TZlindra/ELEC291Project2/Report/main.tex

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

\title{ELEC 291 : Metal Detecting Robot}
\author{Team A9}
\date{April 12th, 2024}

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

\linespread{1.6}
\setlength{\parindent}{0pt} % Disable paragraph indentation

\lstset{style=mystyle}

\begin{document}

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

\newpage

\tableofcontents

\newpage
\section{Introduction}

\subsection{Objective}

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

\

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

\subsection{System Block Diagrams}

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

\section{Investigation}

Prior to settling on a final design, we individually and collaboratively scoped out the
constraints of our project components (listed in the project requirements in Table \ref{tab:project_requirements}).

\subsection{Idea Generation}

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

\subsection{Investigation Design}

To begin our design, we leveraged our knowledge of Labs 4-6 to understand how sub-circuitry and software modules should be implemented.
A few components required further research, such as the Colpitts Oscillator for the metal detector, and the JDY-40 radio module for data transmission. %ToDo : Add Bibliography
For our circuitry, we referred to datasheets to ensure our electrical components were powered in the appropriate voltage ranges.
We also determined capacitances which would enable a stable steady state for the Colpitts Oscillator and for us to meet expected inductance values.
We spent some time understanding the limitations of the JDY-40 and how to properly configure them for communication between the two microcontrollers.

\subsection{Data Collection}

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

\

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

\

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

\subsection{Data Synthesis}

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

\

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

\subsection{Analysis of Results}

From the graphs in \ref{fig:movement_controls_logs} and \ref{fig:movement_controls_logs}, we noted that the latency is displayed as a number of samples. This was due to the fact that we had
many samples per second and wanted to visualize the microcontroller responsiveness to new information. In Figure \ref{fig:movement_controls_logs}, we
see that the direction and speed was transmitted accurately from the STM32 to the EFM8. We modified both X and Y coordinates to test possible combinations and this was received in a reasonable number of samples.
In Figure \ref{fig:inductance_detection_logs}, we see that the inductance values exhibited similar transmission behavior upon change.

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

\section{Design}

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

\subsection{Use of Process}

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

\

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

\

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

\

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

\subsection{Need and Constraint Identification}.

During firmware development, we identified the following constraints from the
documents provided by Dr. Jesus Calvino-Fraga, as well as from our own comprehension : \\

\begin{table}[ht]
    \center
    \begin{tabular}{|l|p{0.6\linewidth}|}
        \hline
        \textbf{Requirements} \\ \hline
        The controller and robot must be driven by two microcontrollers from \\
        different families (e.g., ARM Cortex and 8051). \\ \hline
        The robot must be able to detect metal using an inductor built from \\
        magnet wire and a coil frame. \\ \hline
        The robot must be powered by AA batteries to drive wheels and 9V for \\
        the remaining functions. \\ \hline
        The speed and direction of the robot must be smoothly controlled with a joystick. \\ \hline
        The controller and the robot must wirelessly transmit data to one another. \\ \hline
        The metal detected by the robot should be indicated to \\
        the user via visual and auditory feedback. \\ \hline
        The transmission of data must be reliable and accurate. \\ \hline
    \end{tabular}
    \label{tab:project_requirements}
    \caption{List of Project Requirements}
\end{table}

\subsection{Problem Specification}

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

\

\textbf{JDY Communications}
A key module which required extensive development time was the JDY-40 communication between the STM32 and EFM8 microcontrollers.
The bugs caused by this were the main blocker in integrating our firmware, as the communication was not reliable and often failed to transmit
data between the two microcontrollers.

\

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

\

A major obstacle was finding that Git commits with a functional JDY-40 module would suddenly behave erratically
(i.e. transmission delays, inaccurate data to be received). We believe this was partially due to software bugs, but also due to the high number of \textit{JDY-40s}
in the lab environment during the latter part of the project.

\

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

\

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

\

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

\subsection{Solution Generation}

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

\

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

\

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

\

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

\subsection{Solution Evaluation}

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

\subsection{Safety/Professionalism}

To ensure our product was safe, we developed many safety algorithms in the program. Before the robot can be controlled, the user must enter a 4 digit passcode
to "unlock" the remote controller. This was paired with a lock feature which would disable the controller in the need of an emergency or other purpose. In tandem with this,
we had a power switch to both conserve battery life and to ensure that the robot could not be controlled in this state. In addition, we implemented a speed limiter and turn
limiter on the remote controller for the movement of the robot. If the user wishes to operate at a lower speed without the risk of too much speed, a simple click would enable this.

\

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

\subsection{Detailed Design}

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

As seen in Figure \ref{fig:stm32}, the relevant circuits
include the voltage dividers, joystick (ADC), JDY-40, and LCD. Conversely, in the Figure \ref{fig:efm8}, the important circuits
were the voltage dividers, JDY-40, metal detector and optocoupler/H-bridge circuits.

\

\textbf{Voltage Dividers} \\
We had a total of 4 step down voltage dividers for this project. Since the controller and the robot needed to be battery powered, we were required to use an LM7805 to drop the voltage of a standard 9V alkaline battery to 5V to power circuits such as the EFM8, LCD, speakers and the metal detector circuit. For stabilizing capacitors we used 0.22uF and 0.1uF capacitors as shown in the LM7805 datasheet. Subsequently, this 5V voltage was also dropped down to a voltage of 3v3 to power the ADC, JDY-40s and the STM32. We used 2 1uF capacitors to stabilize the signal.

\

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

\

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

\

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

\

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

\subsubsection{Firmware Design}
This project required a strong firmware foundation to ensure the robot behaved as intended. This entailed developing $C$ programs in close coordination for the STM32 and EFM8 systems.
The fundamental modules include the joystick input standardization, movement logic/PWM control, JDY-40 communications, speakers, and period calculations (metal detector).

\

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

This was paired with some more logic to convert this number into a percentage from 1-100\% for the x and y directions. As shown in Figure \ref{lst:movementstandardized2}, the value was divided by the total in the direction it was pointed to get a percent. This was paired with a minimum
 active threshold of 5\%, due to the joystick value fluctuating slightly when it was not in motion.
\begin{lstlisting} [language=C, caption={PWM Percentage Conversion}, label={lst:movementstandardized2}, basicstyle=\ttfamily\tiny]
if (y_value > MINIMUM_PERCENT_ACTIVE * (4095 - Y_MIDPOINT) || y_value < - MINIMUM_PERCENT_ACTIVE * Y_MIDPOINT) {
    if (y_value >= 0) standardized = (int)(100 * y_value / (4095 - Y_MIDPOINT));
    else if (y_value < 0) standardized = (int)(100 * y_value / (Y_MIDPOINT));
}
\end{lstlisting}

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

\

\textbf{JDY-40 Communications} \\

In order to share data between microcontrollers, we had to ensure our firmware operated deterministically and reliably.
This required ensuring that the data received by each microcontroller was accurate to the transmitted data. It also required ensuring
that this did not slow down the remaining functionality of the system, especially for the robot EFM8 microcontroller.

\

As seen in Figure \ref{fig:firmware_block_diagram}, we decided to periodically transmit data to the JDY-40 radio. This was done
asynchronously via ISRs. Receiving and parsing the data was done in the main function however,
as the subsequent instructions depended on a newly received value. This appeared as a function call to the following function on the STM32.
Note that this only updates the global variable \texttt{RX\_BUFF} when 2 bytes are received.

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

We prioritized frequent data transmission of movement controls from the joystick and implemented an STM32 ISR with a software counter
to transmit this every $250 ms$ via UART communication. This ensured we can smoothly control the speed and
direction of the PWM for the robot Optocoupler and H-Bridge circuitry.

\begin{lstlisting} [language=C, caption={EFM8 : Timer 21 ISR}, label={lst:timer21isr}, basicstyle=\ttfamily\tiny]
void TIM21_Handler(void) {
	TIM21->SR &= ~BIT0; // Clear Update Interrupt Flag
	TX21Count++;

	if (TX21Count > 250) {
		TX21Count = 0;
		TX_XY();
	}
}
\end{lstlisting}

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

\

Data parsing and validation was an additional layer of complicated for the EFM8 system, as we needed to accurately process the X, Y, and Z values from
the STM32 transmission. This involved checking the length to ensure it was within the expected range of 12-14 characters. Note that we had to transmit a fixed length from the
STM32 to account for this. Following this initial validation, we implemented a custom function to trim the non-numeric characters from the string, and assign the relevant data
to the respect variables. This is shown in the Appendix (\ref{lst:efm8_jdy40rx}).

\

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

\

\textbf{Period Measurement and Inductance Calculation}

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

    ... // Wait for the signal to go low

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

    return (overflow_count*65536+TH0*256+TL0);
}
\end{lstlisting}

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

    return (int)(MILLI_MULTIPLIER * MILLI_MULTIPLIER * I_kH);
}
\end{lstlisting}

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

\

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

\

\textbf{Speaker} \\
We implemented the speaker on the controller using Timer 2 of the STM32. We used a base frequency of 7040Hz, as this allowed us to output an clear and observable
"A" note (sample chart shown here: \ref{fig:music_frequencies}), whereas other frequencies have decimal points (dividing the frequency by $2^n$).
In the code shown in \ref{lst:Speaker}, the \texttt{new\_ratio} value served as a counter in the Timer 2 ISR to control the PWM speed for the speaker.
The change in frequency was tied to the inductance value measured by the EFM8.

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

    new_freq = TICK_FREQ_TIM2 / new_ratio;

    return new_ratio;
}
\end{lstlisting}

\noindent

\subsection{Solution Assessment}

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

\

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

    ... # Parse and Process Data

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

    if log_df.empty:
        log_df = new_df
    else:
        log_df = pd.concat([log_df, new_df], ignore_index=True)

    s += 1

log_df.to_csv('Coordinate_Logs.csv', index=False)
\end{lstlisting}

This generated the $csv$ file with the following data in Table \ref{table:coordinates_log_table}.

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

We performed a similar test for inductance logs in Table \ref{table:inductance_log_table}.

\section{Life Long Learning}

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

\

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

\

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

\section{Conclusion}

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

\renewcommand{\refname}{}

\newpage

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

    \bibitem{SlidesPDF} Calvino-Fraga, Jesus, \textit{ELEC291\_Project\_2\_Met}. University of British Columbia, 2024.

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

\end{thebibliography}

\section{Bibliography}
\begin{itemize}
    \item ChatGPT, chat.openai.com, 2022.
    \item EFM8 Laser Bee Family EFM8LB1 Data Sheet - Silicon Labs, www.silabs.com/documents/public/data-sheets/efm8lb1-datasheet.pdf, 2024.
    \item EFM8 Laser Bee Family EFM8LB1 Reference Manual, www.silabs.com/documents/public/reference-manuals/efm8lb1-rm.pdf, 2019.
    \item JDY-40 Wireless Serial Port Module, w.electrodragon.com/w/images/0/05/EY-40\_English\_manual.pdf.
    \item Merlo, Maria Grazia. “The 4 Principles of an Effective Work Breakdown Structure.” A Journey into Software Best Practices with Maria Grazia Merlo, mariagraziamerlo.com/2015/12/27/the-4-core-principles-of-an-effective-work-breakdown-structure/, 2015.
    \item Microchip, ww1.microchip.com/downloads/aemDocuments/documents/APID/ProductDocuments/DataSheets/MCP1700-Data-Sheet-20001826F.pdf, 2022.
    \item Mouser, www.mouser.com/datasheet/2/239/LTV-8X7\_series\_201610\_-1544776.pdf.
    \item STM32, Datasheet - Stm32l051x6 Stm32l051x8 - Access Line, www.st.com/resource/en/datasheet/stm32l051c6.pdf, 2019.
    \item STM32, RM0377 Reference Manual - -Based 32-Bit Mcus, www.st.com/resource/en/reference\_manual/rm0377-ultralowpower-stm32l0x1-advanced-armbased-32bit-mcus-stmicroelectronics.pdf, 2022.
    \item Storr, Wayne. “Colpitts Oscillator Tutorial and Colpitts Oscillator Design.” Basic Electronics Tutorials, www.electronics-tutorials.ws/oscillator/colpitts.html, 2022.
\end{itemize}

\clearpage
\section{Appendix}

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

\begin{figure}[htbp]
    \centering
    
    \caption{Example JDY-40 connections with a Microcontroller}
    \label{fig:JDY-40}
\end{figure}

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

    count++;

\end{lstlisting}

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

        SFRPAGE=0x10;
        TF4H = 0; // Clear Timer4 interrupt flag
        TXcount++;

        if(TXcount >= 250){
            TXcount=0;
            flag == 0;
        }

        if (current_TR0 == 1) TR0 = 1;
        if (current_TR5 == 1) TR5 = 1;
    }
\end{lstlisting}

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

    //printf("%p \n", y);
    //printf("%p \n", x);

    *xin = stringToInt(x);
    *yin = stringToInt(y);
    *zyn = stringToInt(z);

    free(x);
    free(y);
    free(z);
}
\end{lstlisting}

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

    // printf("Frequency: %ld Hz\n", frequency);

    if (count>0) return frequency;
    else return 0;
}
\end{lstlisting}

\end{document}
