TZlindra/ELEC291Project2/(list of files, cad)

Other CAD files:
EFM8/Examples/LCD/main.obj
EFM8/Robot/Source_Code/main.obj
EFM8/Examples/ADC/ADC.obj
EFM8/Examples/All_timers/All_timers.obj
EFM8/Examples/Blinky/Blinky.obj
EFM8/Examples/BlinkyISR/BlinkyISR.obj
EFM8/Examples/HelloWorld/HelloWorld.obj
EFM8/Examples/JDY40/EFM8_JDY40_test.obj
EFM8/Examples/LCD/lcd.obj
EFM8/Examples/Period/PeriodEFM8.obj
EFM8/Examples/Professor_JDY/EFM8_JDY40_test.obj
EFM8/Examples/Robot_Base/Robot_Base.obj
EFM8/Examples/Uart1/EFM8_uart1_test.obj
EFM8/Robot/EFM8_Prog/EFM8_prog.obj
EFM8/Robot/Source_Code/movement.obj
STM32/Examples/stm32flash/BO230/BO230.obj
STM32/Examples/WAV_Sound/computer_sender.obj
STM32/stm32flash/BO230/BO230.obj
EFM8/Examples/LCD/startup.obj
EFM8/Robot/Source_Code/JDY40.obj
EFM8/Robot/Source_Code/movement_integration.obj
EFM8/Robot/Source_Code/global.obj
EFM8/Robot/Source_Code/speaker.obj
EFM8/Robot/Source_Code/inductance.obj
