TZlindra/ELEC291Project2/Regression_Tests/Inductance/Inductance_Logs.csv

Datetime | Robot Inductance | Controller Inductance
2024-04-11 13:44:07.003536 | 492.0
2024-04-11 13:44:07.058682 | 490.0 | 490.0
2024-04-11 13:44:07.346862 | 490.0 | 490.0
2024-04-11 13:44:07.627616 | 490.0 | 490.0
2024-04-11 13:44:07.934766 | 492.0 | 490.0
2024-04-11 13:44:08.224805 | 492.0 | 490.0
2024-04-11 13:44:08.516710 | 490.0 | 490.0
2024-04-11 13:44:08.801755 | 490.0 | 490.0
2024-04-11 13:44:09.091120 | 490.0 | 490.0
2024-04-11 13:44:09.396327 | 490.0 | 487.0
2024-04-11 13:44:09.677981 | 492.0 | 490.0
2024-04-11 13:44:09.966508 | 490.0 | 490.0
2024-04-11 13:44:10.253418 | 492.0 | 490.0
2024-04-11 13:44:10.564472 | 490.0 | 487.0
2024-04-11 13:44:10.849895 | 490.0 | 487.0
2024-04-11 13:44:11.139413 | 490.0 | 490.0
2024-04-11 13:44:11.421172 | 490.0 | 490.0
2024-04-11 13:44:11.733601 | 490.0 | 490.0
2024-04-11 13:44:12.010898 | 490.0 | 490.0
2024-04-11 13:44:12.309989 | 492.0 | 490.0
2024-04-11 13:44:12.595442 | 492.0 | 490.0
2024-04-11 13:44:12.902049 | 490.0 | 490.0
2024-04-11 13:44:13.186210 | 490.0 | 490.0
2024-04-11 13:44:13.475678 | 487.0 | 490.0
2024-04-11 13:44:13.763262 | 480.0 | 490.0
2024-04-11 13:44:14.068412 | 480.0 | 487.0
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
