TZlindra/ELEC291Project2/Regression_Tests/Coordinates/Coordinate_Logs.csv

Datetime | Robot X | Robot Y | Robot Z | Controller X | Controller Y | Controller Z
2024-04-09 15:34:41.234182 |  |  |  | 0.0 | 0.0 | 0.0
2024-04-09 15:34:41.336645 |  |  |  | 0.0 | 0.0 | 0.0
2024-04-09 15:34:41.624354 | 0.0 | 0.0 | 0.0 | 0.0 | 0.0 | 0.0
2024-04-09 15:34:41.912171 | 0.0 | 0.0 | 0.0 | 0.0 | 99.0 | 0.0
2024-04-09 15:34:42.202581 | 0.0 | 0.0 | 0.0 | 0.0 | 99.0 | 0.0
2024-04-09 15:34:42.493474 | 0.0 | 99.0 | 0.0 | 0.0 | 99.0 | 0.0
2024-04-09 15:34:42.797305 | 0.0 | 99.0 | 0.0 | 0.0 | 99.0 | 0.0
2024-04-09 15:34:43.082199 | 0.0 | 99.0 | 0.0 | 0.0 | 99.0 | 0.0
2024-04-09 15:34:43.372573 | 0.0 | 99.0 | 0.0 | 0.0 | 99.0 | 0.0
2024-04-09 15:34:43.656584 | 0.0 | 99.0 | 0.0 | 0.0 | 99.0 | 0.0
2024-04-09 15:34:43.948304 | 0.0 | 99.0 | 0.0 | 0.0 | 99.0 | 0.0
2024-04-09 15:34:44.247106 | 0.0 | 99.0 | 0.0 | 0.0 | 99.0 | 0.0
2024-04-09 15:34:44.542237 | 0.0 | 99.0 | 0.0 | 0.0 | 99.0 | 0.0
2024-04-09 15:34:44.832331 | 0.0 | 99.0 | 0.0 | 0.0 | 99.0 | 0.0
2024-04-09 15:34:45.117004 | 0.0 | 99.0 | 0.0 | 0.0 | 99.0 | 0.0
2024-04-09 15:34:45.408791 | 0.0 | 99.0 | 0.0 | 99.0 | 99.0 | 0.0
2024-04-09 15:34:45.710676 | 0.0 | 99.0 | 0.0 | 99.0 | 99.0 | 0.0
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
