TZlindra/ELEC291Project2/STM32/Controller/main.c

// LQFP32 pinout
//                    ----------
//              VDD -|1      32|- VSS
//             PC14 -|2      31|- BOOT0
//             PC15 -|3      30|- PB7 (Button D)
//             NRST -|4      29|- PB6 (Button C)
//             VDDA -|5      28|- PB5 (Button B)
// LCD_RS      PA0 -|6       27|- PB4
// LCD_E       PA1 -|7       26|- PB3 (Button A)
// LCD_D4      PA2 -|8       25|- PA15 (USART2 RX)
// LCD_D5      PA3 -|9       24|- PA14 (USART2 TX)
// LCD_D6      PA4 -|10      23|- PA13
// LCD_D7      PA5 -|11      22|- PA12 (Button)
//             PA6 -|12      21|- PA11
//             PA7 -|13      20|- PA10 (Reserved for RXD)
// (ADC_IN8)   PB0 -|14      19|- PA9  (Reserved for TXD)
// (ADC_IN9)   PB1 -|15      18|- PA8  (Speaker)
//             VSS -|16      17|- VDD
//                    ----------

#include "global.h"
#include "lcd.h"
#include "speaker.h"
#include "adc.h"
#include "UART2.h"
#include "JDY40.h"
#include "movement.h"
#include "frequency_calc.h"
#include "passcode.h"

char LCD_BUFF[CHARS_PER_LINE]; // Buffer for LCD Display

volatile int Timer2Count = 0;
volatile int TX21Count = 0;
volatile float SpeakerRatio = 1;
volatile int SpeakerEnabled = 0;
int ForceSpeakerOff = 0;

volatile float inductance_microH = 0;

float x = 0, y = 0, z = 0;
int standardized_x = 0, standardized_y = 0;
int sensitivity_x = 0, sensitivity_y = 0;

void ConfigPinsLCD(void);
void ConfigPinButtonZ(void);
void ConfigPinADC(void);
void ConfigPinsUART2(void);
void ConfigPinSpeaker(void);
void ConfigPasscodeButtonPins(void);

void display_x_y(int x, int y);
void display_adc(float x, int standardized_x, float y, int standardized_y);
void display_inductance_mH(float inductance_mH);

// Interrupt service routines are the same as normal
// subroutines (or C funtions) in Cortex-M microcontrollers.
// The following should happen at a rate of 1kHz.
// The following function is associated with the TIM2 interrupt
// via the interrupt vector table defined in startup.c
void TIM2_Handler(void) {
	TIM2->SR &= ~BIT0; // Clear Update Interrupt Flag
	Timer2Count++;
	if ((Timer2Count >= SpeakerRatio) && (SpeakerEnabled == 1) && (ForceSpeakerOff == 0)) {
		TIM2->CCR1 = (TIM2->CCR1+16)&0xFF;
		Timer2Count = 0;
		ToggleSpeaker(); // Toggle Speaker
	}
}

void TIM21_Handler(void) {
	TIM21->SR &= ~BIT0; // Clear Update Interrupt Flag
	TX21Count++;

	if (TX21Count > 250) {
		TX21Count = 0;
		TX_XY();
	}
}

void ConfigPinsLCD(void) {
	RCC->IOPENR |= BIT0; // peripheral clock enable for port A

	// Make pins PA0 to PA5 outputs (page 200 of RM0451, two bits used to configure: bit0=1, bit1=0)
    GPIOA->MODER = (GPIOA->MODER & ~(BIT0|BIT1)) | BIT0; // PA0
	GPIOA->OTYPER &= ~BIT0; // Push-pull

    GPIOA->MODER = (GPIOA->MODER & ~(BIT2|BIT3)) | BIT2; // PA1
	GPIOA->OTYPER &= ~BIT1; // Push-pull

    GPIOA->MODER = (GPIOA->MODER & ~(BIT4|BIT5)) | BIT4; // PA2
	GPIOA->OTYPER &= ~BIT2; // Push-pull

    GPIOA->MODER = (GPIOA->MODER & ~(BIT6|BIT7)) | BIT6; // PA3
	GPIOA->OTYPER &= ~BIT3; // Push-pull

    GPIOA->MODER = (GPIOA->MODER & ~(BIT8|BIT9)) | BIT8; // PA4
	GPIOA->OTYPER &= ~BIT4; // Push-pull

    GPIOA->MODER = (GPIOA->MODER & ~(BIT10|BIT11)) | BIT10; // PA5
	GPIOA->OTYPER &= ~BIT5; // Push-pull
}

void ConfigPinButtonZ() {
	RCC->IOPENR |= RCC_IOPENR_GPIOAEN; // Peripheral Clock Enable for Port A
	GPIOA->MODER &= ~(BIT24 | BIT25); // Make Pin PA12 Input

	// Activate Pull-Up Resistor for Pin PA12
	GPIOA->PUPDR |= BIT24;
	GPIOA->PUPDR &= ~(BIT25);
}

void ConfigPinADC(void) {
	// Configure the pin used for analog input: PB0 (pin 14)
	RCC->IOPENR |= RCC_IOPENR_GPIOBEN; // Peripheral Clock Enable for Port B
	GPIOB->MODER |= (BIT0|BIT1);  // Select analog mode for PB0 (pin 14 of LQFP32 package)

	// Configure the pin used for analog input: PB1 (pin 15)
	RCC->IOPENR  |= BIT1;         // peripheral clock enable for port B
	GPIOB->MODER |= (BIT2|BIT3);  // Select analog mode for PB1 (pin 15 of LQFP32 package)
}

void ConfigPinsUART2(void) {
	GPIOA->OSPEEDR = 0xFFFFFFFF; // All pins of port A configured for very high speed! Page 201 of RM0451

	RCC->IOPENR |= RCC_IOPENR_GPIOAEN; // Enable clock for GPIO Port A

    GPIOA->MODER = (GPIOA->MODER & ~(BIT27|BIT26)) | BIT26; // Make pin PA13 output (page 200 of RM0451, two bits used to configure: bit0=1, bit1=0))
	GPIOA->ODR |= BIT13; // 'set' pin to 1 is normal operation mode.

	GPIOA->MODER &= ~(BIT22 | BIT23); // Make PA11 Input

	// Activate Pull-Up Resistor for Pin PA11
	GPIOA->PUPDR |= BIT22;
	GPIOA->PUPDR &= ~(BIT23);
}

void ConfigPinSpeaker(void) {
	RCC->IOPENR |= RCC_IOPENR_GPIOAEN; // Enable clock for GPIO Port A
    GPIOA->MODER = (GPIOA->MODER & ~(BIT17|BIT16)) | BIT16; // PA8
}

void ConfigLEDPins(void) {
    GPIOA->MODER = (GPIOA->MODER & ~(BIT12|BIT13)) | BIT12; // PA6
	GPIOA->OTYPER &= ~BIT6; // Push-pull

    GPIOA->MODER = (GPIOA->MODER & ~(BIT14|BIT15)) | BIT14; // PA7
	GPIOA->OTYPER &= ~BIT7; // Push-pull

}

void ConfigPasscodeButtonPins(void) {
    RCC->IOPENR |= RCC_IOPENR_GPIOBEN; // Peripheral Clock Enable for Port B
    GPIOB->MODER &= ~(BIT14 | BIT15); // Make Pin PB7 Input
	GPIOB->PUPDR |= BIT14;
	GPIOB->PUPDR &= ~(BIT15);

    GPIOB->MODER &= ~(BIT12 | BIT13); // Make Pin PB6 Input
	GPIOB->PUPDR |= BIT12;
	GPIOB->PUPDR &= ~(BIT13);

    GPIOB->MODER &= ~(BIT10 | BIT11); // Make Pin PB5 Input
	GPIOB->PUPDR |= BIT10;
	GPIOB->PUPDR &= ~(BIT11);

    GPIOB->MODER &= ~(BIT6 | BIT7); // Make Pin PB3 Input
	GPIOB->PUPDR |= BIT6;
	GPIOB->PUPDR &= ~(BIT7);
}

int isButtonPressedGPIOA(int ButtonPin) {
	return !(GPIOA->IDR & ButtonPin);
}

int isButtonPressedGPIOB(int ButtonPin) {
	return !(GPIOB->IDR & ButtonPin);
}

void display_x_y(int x, int y) {
	sprintf(LCD_BUFF, "MOV(%d, %d)", x, y);
	LCDprint(LCD_BUFF, 2, 1);
}

void display_adc(float x, int standardized_x, float y, int standardized_y) {
	sprintf(LCD_BUFF, "X:%.1f = %d", x, standardized_x);
	printf("%s\r\n", LCD_BUFF);
	LCDprint(LCD_BUFF, 1, 1);

	sprintf(LCD_BUFF, "Y:%.1f = %d", y, standardized_y);
	printf("%s\r\n", LCD_BUFF);
	LCDprint(LCD_BUFF, 2, 1);
}

void display_inductance_mH(float inductance_mH) {
	sprintf(LCD_BUFF, "I: %.3f mH", inductance_mH / MILLI_MULTIPLIER);
	LCDprint(LCD_BUFF, 1, 1);
}

void update_sensitivity_x(void) {
	int sensitivity_count = 0;

	if (isButtonPressedGPIOB(BUTTON_S0)) {
		waitms(DEBOUNCE);
		if (isButtonPressedGPIOB(BUTTON_S0)) {
			// printf("Sensitivity X: %d\r\n", sensitivity_x);
			sensitivity_x++;
			if (sensitivity_x == 3) sensitivity_x = 0;

			while(isButtonPressedGPIOB(BUTTON_S0) && sensitivity_count < 500) sensitivity_count++;
		}
	}
}

void update_sensitivity_y(void) {
	int sensitivity_count = 0;

	if (isButtonPressedGPIOB(BUTTON_S1)) {
		waitms(DEBOUNCE);
		if (isButtonPressedGPIOB(BUTTON_S1)) {
			// printf("Sensitivity Y: %d\r\n", sensitivity_x);
			sensitivity_y++;
			if (sensitivity_y == 3) sensitivity_y = 0;

			sensitivity_count = 0;
			while(isButtonPressedGPIOB(BUTTON_S1) && sensitivity_count < 500) sensitivity_count++;
		}
	}
}

void CheckForceSpeakerOff(void) {
	if (isButtonPressedGPIOB(BUTTON_S2)) {
		waitms(DEBOUNCE);
		if (isButtonPressedGPIOB(BUTTON_S2)) {
			ForceSpeakerOff = !ForceSpeakerOff;
		}
	}
}

void checkLock(void) {
	if (isButtonPressedGPIOB(BUTTON_S3)) {
		waitms(DEBOUNCE);
		if (isButtonPressedGPIOB(BUTTON_S3) && isButtonPressedGPIOB(BUTTON_S0)) {
			SpeakerEnabled = 0;
    		printf("LOCKED!\r\n");
    		LCDprint("LOCKED!", 1, 1);
    		LCDprint("", 2, 1);
    		waitms(1000); // Wait 1s
    		getPasscode();
		}
	}
}

void main(void) {
	int success_count = 0; // Used to Filter Inductance RX Noise
	int z_count = 0; // Used to Filter Button Z Noise

	ConfigPinsUART2();
	InitUART2(9600);
	ConfigJDY40();

	ConfigPinsLCD();
	LCD_4BIT();
	ConfigPinButtonZ();
	ConfigPinADC();
	ConfigPinSpeaker();
	ConfigPasscodeButtonPins();
	ConfigLEDPins();

	InitTimer2();
	InitTimer21();

	initADC();

	waitms(500); // Wait for putty to start.
	printf("\x1b[2J\x1b[1;1H"); // Clear screen using ANSI escape sequence.

    getPasscode();

	while (1) {
		checkLock();

		x = -1*(readADC(ADC_CHSELR_CHSEL8)-X_MIDPOINT);
		y = -1*(readADC(ADC_CHSELR_CHSEL9)-Y_MIDPOINT);

		z = 0;
		if (isButtonPressedGPIOA(BUTTON_Z)) {
			waitms(DEBOUNCE);
			if (isButtonPressedGPIOA(BUTTON_Z)) z = 1;

			z_count = 0;
			while(isButtonPressedGPIOA(BUTTON_Z) && z_count < 500) z_count++;
		}

		update_sensitivity_x();
		update_sensitivity_y();

		standardized_x = standardize_x(x, sensitivity_x);
		standardized_y = standardize_y(y, sensitivity_y);

		// printf("X:%d, Y:%d, Z:%d\r\n", standardized_x, standardized_y, z);

		Update_XYZ(standardized_x, standardized_y, z);
		RX_I(); // Receive Inductance Value

		// display_buffs();
		// inductance_microH = 850.0;
		inductance_microH = Update_I(inductance_microH);
		printf("%0f\r\n", inductance_microH);

		// if (isButtonPressedGPIOB(BUTTON_S2)) SpeakerRatio = SetSpeakerFreq(inductance_microH, SpeakerRatio);

		if ((inductance_microH < 473.0) && (inductance_microH >= 400.0)) {
			if (success_count++ >= 0) {
				SpeakerEnabled = 1;
				SpeakerRatio = SetSpeakerFreq(inductance_microH, SpeakerRatio);
			}
		} else {
			success_count = 0;
			SpeakerEnabled = 0;
		}

		CheckForceSpeakerOff();

		// Display the ADC values on the LCD

		display_inductance_mH(inductance_microH);
		display_x_y(standardized_x, standardized_y);

		fflush(stdout); // GCC printf wants a \n in order to send something.  If \n is not present, we fflush(stdout)
		waitms(200);
	}
}
