TZlindra/ELEC291Project2/EFM8/Robot/Source_Code/movement.c

#include "movement.h"

#define LEFT_MOTOR_LHS  P2_4    //brown
#define LEFT_MOTOR_RHS  P2_3    //black
#define RIGHT_MOTOR_LHS P2_2    //grey/brown
#define RIGHT_MOTOR_RHS P2_1    //red

volatile int count = 0;
volatile long int timer = 0;

int PWM_percent_y = 0;
int PWM_percent_x = 0;
float left_wheel = 0;
float right_wheel = 0;
float new_right_wheel;
int prev_PWM_percent_x = 0;
int prev_PWM_percent_y = 0;
int state = 0;

void TIMER5Init(void) {
    // Initialize timer 5 for periodic interrupts
	SFRPAGE=0x10;
	TMR5CN0=0x00;   // Stop Timer5; Clear TF5; WARNING: lives in SFR page 0x10
	CKCON1|=0b_0000_0100; // Timer 5 uses the system clock
	TMR5RL=(0x10000L-(SYSCLK/(2*TIMER_5_FREQ))); // Initialize reload value
	TMR5=0xffff;   // Set to reload immediately
	EIE2|=0b_0000_1000; // Enable Timer5 interrupts
	TR5=1;         // Start Timer5 (TMR5CN0 is bit addressable)
}

void Timer5_ISR (void) interrupt INTERRUPT_TIMER5 {
    int current_TR0 = TR0, current_TR5 = TR5;
	TR0 = 0, TR5 = 0;

	SFRPAGE=0x10;
	TF5H = 0; // Clear Timer5 interrupt flag

    // P1_2 = !P1_2;
    //P1_3 = !P1_3;
    //P2_1 = !P2_1;

    if (state)
    {
        if (timer > 50000)
        {
            timer = 0;
            state = 0;
            PWM_percent_y = 0;
            left_wheel = 0;
            new_right_wheel = 0;
        }
        else if (timer > 20000)
        {
            PWM_percent_y = 100;
            left_wheel = 75;
            new_right_wheel = 75;
        }
        else
        {
            PWM_percent_y = 100;
            left_wheel = 75;
            new_right_wheel = 0;
        }
        timer++;
    }

    if (count > 100)
    {
        count = 0;
    }
    if (PWM_percent_y >= 0)
    {
        LEFT_MOTOR_LHS = (count > left_wheel ) ? 0:1;
        RIGHT_MOTOR_LHS = (count > new_right_wheel) ? 0:1;
    }
    else
    {
        LEFT_MOTOR_LHS = (count > left_wheel) ? 1:0;
        RIGHT_MOTOR_LHS = (count > new_right_wheel) ? 1:0;
    }

    count++;

    if (current_TR0 == 1) TR0 = 1;
    if (current_TR5 == 1) TR5 = 1;
}

void idle(void) {
    LEFT_MOTOR_LHS = 0;
    RIGHT_MOTOR_LHS = 0;
    LEFT_MOTOR_RHS = 0;
    RIGHT_MOTOR_RHS = 0;
}

void straight(void) {
    LEFT_MOTOR_RHS = 0;
    RIGHT_MOTOR_RHS = 0;
}

void backward(void) {
    LEFT_MOTOR_RHS = 1;
    RIGHT_MOTOR_RHS = 1;
}

void PWM_manager(float x_value, float y_value) {
    if (x_value >= 0) // RIGHT TURN
    {
        left_wheel = abs(y_value);
        right_wheel = (100 - abs(x_value)) * abs(y_value) / 100;
    }
    else if (x_value < 0) // LEFT TURN
    {
        left_wheel = (100 - abs(x_value)) * abs(y_value) / 100;
        right_wheel = abs(y_value);
    }

    // to account for the RIGHT wheel being stronger than the LEFT wheel
    if (abs(y_value) <= 25) new_right_wheel = 0.9*right_wheel;
    else if (abs(y_value) <= 50) new_right_wheel = 0.95*right_wheel;
    else if (abs(y_value) <= 75) new_right_wheel = 0.95*right_wheel;
    else if (abs(y_value) <= 100) new_right_wheel = 0.95*right_wheel;
    else new_right_wheel = 0.95*right_wheel;
}

void movement_manager(float PWM_percent_y, float prev_PWM_percent_y) {
    if (prev_PWM_percent_y != PWM_percent_y)
    {
        if (PWM_percent_y >= 0)
        {
            straight();
        }
        else
        {
            backward();
        }
    }

}

void movement_init(void) {
    idle();
}

void movement_loop(float x, float y) {
        // printf("JDY x: %f, JDY y: %f\r\n", x, y);
        PWM_percent_x = x;
        PWM_percent_y = y;
        // printf("PWM_percent x: %f, PWM_percent y: %f\r\n", x, y);

        movement_manager(PWM_percent_y, prev_PWM_percent_y);
		PWM_manager(PWM_percent_x, PWM_percent_y);
        prev_PWM_percent_x = PWM_percent_x;
        prev_PWM_percent_y = PWM_percent_y;
}

void parking(void) {
    state = 1;
}
