TZlindra/ELEC291Project2/STM32/Controller/adc.c

#include  "../Common/Include/stm32l051xx.h"
#include "adc.h"

// All of this code is mostly copy/paste from the STM32L05X reference manual RM0451.

void initADC(void) {
	RCC->APB2ENR |= BIT9; // peripheral clock enable for ADC (page 175 or RM0451)

	// ADC clock selection procedure (page 746 of RM0451)
	/* (1) Select PCLK by writing 11 in CKMODE */
	ADC1->CFGR2 |= ADC_CFGR2_CKMODE; /* (1) */

	// ADC enable sequence procedure (page 745 of RM0451)
	/* (1) Clear the ADRDY bit */
	/* (2) Enable the ADC */
	/* (3) Wait until ADC ready */
	ADC1->ISR |= ADC_ISR_ADRDY; /* (1) */
	ADC1->CR |= ADC_CR_ADEN; /* (2) */
	if ((ADC1->CFGR1 & ADC_CFGR1_AUTOFF) == 0)
	{
		while ((ADC1->ISR & ADC_ISR_ADRDY) == 0) /* (3) */
		{
		}	/* For robust implementation, add here time-out management */

	}

	// Calibration code procedure (page 745 of RM0451)
	/* (1) Ensure that ADEN = 0 */
	/* (2) Clear ADEN */
	/* (3) Set ADCAL=1 */
	/* (4) Wait until EOCAL=1 */
	/* (5) Clear EOCAL */
	if ((ADC1->CR & ADC_CR_ADEN) != 0) /* (1) */
	{
		ADC1->CR |= ADC_CR_ADDIS; /* (2) */
	}
	ADC1->CR |= ADC_CR_ADCAL; /* (3) */
	while ((ADC1->ISR & ADC_ISR_EOCAL) == 0) /* (4) */
	{
		/* For robust implementation, add here time-out management */
	}
	}


int readADC(unsigned int channel) {
	// Single conversion sequence code example - Software trigger (page 746 of RM0451)
	/* (1) Select HSI16 by writing 00 in CKMODE (reset value) */
	/* (2) Select the auto off mode */
	/* (3) Select channel */
	/* (4) Select a sampling mode of 111 i.e. 239.5 ADC clk to be greater than17.1us */
	/* (5) Wake-up the VREFINT (only for VRefInt) */
	//ADC1->CFGR2 &= ~ADC_CFGR2_CKMODE; /* (1) */
	ADC1->CFGR1 |= ADC_CFGR1_AUTOFF; /* (2) */
	ADC1->CHSELR = channel; /* (3) */
	ADC1->SMPR |= ADC_SMPR_SMP_0 | ADC_SMPR_SMP_1 | ADC_SMPR_SMP_2; /* (4) */
	if(channel==ADC_CHSELR_CHSEL17)
	{
			ADC->CCR |= ADC_CCR_VREFEN; /* (5) */
}

	/* Performs the AD conversion */
	ADC1->CR |= ADC_CR_ADSTART; /* start the ADC conversion */
	while ((ADC1->ISR & ADC_ISR_EOC) == 0) /* wait end of conversion */
	{
		/* For robust implementation, add here time-out management */
	}

	return ADC1->DR; // ADC_DR has the 12 bits out of the ADC
}
