TZlindra/ELEC291Project2/(commit log)

2024-03-12 initial stuff
    [BO230.obj]
2024-03-12 STM32 Examples and Flash Included
    [BO230.obj, computer_sender.obj]
2024-03-14 ADC Initialized
2024-03-14 ADC Display Updated
2024-03-18 EFM8 Folder
    [EFM8_JDY40_test.obj]
2024-03-19 End of Day 2024-03-18
    PWM Working With Professor Code
    Init EFM8 Code
    [Blinky.obj, EFM8_JDY40_test.obj, EFM8_prog.obj, PeriodEFM8.obj, main.obj]
2024-03-19 Speaker and ADC all 0 in middle
2024-03-19 1:44 march 19th
    [EFM8_prog.obj]
2024-03-19 STM32 Partial Integration 3:00 PM on 2024-03-19
2024-03-21 couple changes
2024-03-22 Created New Beta for STM32
2024-03-23 Commented Out Timer 2 Code Temporarily, Need to Fix Channel. Updating Makefile and EFM8 Movement Code
    [ADC.c, All_timers.c, Blinky.asm, Blinky.c, BlinkyISR.c, Clon_EFM8LB1.c]
2024-03-23 Fixed the Goddamn Timer Issue. Need to Parse Strings and Update Speaker Frequencies Now
    [JDY40.c, main.c, speaker.c]
2024-03-26 Working movement_new.c
    [All_timers.obj, movement_new.obj, test.obj, testmovement.obj]
2024-03-26 2pm tuesday
    [movement_new.obj]
2024-03-26 2:34 tuesday
    [movement_new_new.obj]
2024-03-27 PWM Movement doesnt work
    [EFM8_uart1_test.obj]
2024-03-27 Transmission Fixes in Progress
    [ADC.obj, main.obj]
2024-03-27 Tranmission STM32 - EFM8 Works
2024-03-27 I dont know anymore
    [main.obj]
2024-03-27 Something Works for Tranmission STM32 - EFM8 ISR.
    [EFM8_JDY40_test.obj]
2024-03-28 Testing 2
    [main.obj]
2024-03-28 Testing 3
    [main.obj]
2024-03-28 Files are Linked Together. Need to Fix JDY TX/RX for EFM8 and RX for STM32
    [JDY40.obj, main.obj]
2024-03-28 Timer5 Started for EFM8
    [JDY40.obj, main.obj]
2024-03-28 Transmission Problems. Need Eyes on Code
    [EFM8_JDY40_test.obj, main.obj]
2024-03-28 Start of Day 2024-03-28
    [EFM8_JDY40_test.obj]
2024-03-28 MILESTONE : STM32 RECEIVING
    [EFM8_JDY40_test.obj]
2024-03-28 Receive Update on STM32
2024-03-28 2024-03-28 2:10 PM
    [JDY40.obj, main.obj]
2024-03-28 MILESTONE : TX and RX for Both STM32 and EFM8
2024-03-28 Functional Transmission with STM32-EFM8
2024-03-29 Passcode Lock Software Works, Issues with Button Pins. Need to Refactor Global Header
    [ADC.obj, All_timers.obj, Blinky.obj, EFM8_JDY40_test.obj, EFM8_uart1_test.obj, JDY40.obj, PeriodEFM8.obj, lcd.obj]
2024-03-29 Global File for STM32
2024-03-29 Looks like Working with global.c File so Far
    [JDY40.obj]
2024-03-29 Passcode Display Working. Issue with Button Pins
    [global.h, main.c, passcode.c]
2024-03-29 Passcode Doesn't Require Delays
    [testmovement.obj]
2024-03-29 JDY Transmission and Receive Set Up. Slightly Fast TX
    [movement_new.obj]
2024-03-29 Refactored JDY for EFM8
    [JDY40.obj, global.obj, main.obj, test_main.obj]
2024-03-29 End of Day 2024-03-29
    [main.obj, movement_integration.obj]
2024-03-30 JDY Working with Large Model Compiler. Need to include movement_integration
    [JDY40.obj, global.obj, main.obj, movement_integration.obj]
2024-03-30 Partial Integration with Boatload for JDY Bugs, Need to Test with Motor
    [main.obj, movement_integration.obj, movement_new_new.obj, test_main.obj]
2024-03-30 Freed Memory
    [JDY40.obj, main.obj]
2024-03-30 Reduced TX Delay for STM32
    [movement_integration.obj]
2024-03-30 End of Day 2024-03-30
    [JDY40.obj, global.obj, inductance.obj, main.obj, movement_integration.obj]
2024-03-31 Created Functional 2 Button Lock
2024-03-31 TX and RX functional on STM32 and EFM8
    [BlinkyISR.obj, EFM8_prog.obj, HelloWorld.obj, JDY40.obj, global.obj, inductance.obj, main.obj, movement_integration.obj]
2024-03-31 Separated Buffs for JDY Transmission
    [JDY40.obj, main.obj]
2024-03-31 Works with 5 Bit Number
    [JDY40.obj, test.obj]
2024-03-31 Works with 8 Digit Number
    [JDY40.obj]
2024-03-31 MilliHenry Value is Calculated. Issue with Period Detection
    [JDY40.obj, inductance.obj, main.obj]
2024-03-31 Speaker Logic Implemented : ToDo -> Better Speaker Sounds? Fix Period Detection, Annoying Reset Issue, Wifi Module
    [JDY40.obj, global.obj, inductance.obj, main.obj, movement_integration.obj]
2024-04-01 Long Ints for Freq
    [JDY40.obj, Robot_Base.obj, global.obj, inductance.obj, main.obj, movement_integration.obj]
2024-04-01 Testing New Features, Broke Movement
    [JDY40.obj, Robot_Base.obj, main.obj, movement_integration.obj, movement_new_new.obj]
2024-04-01 3 Settings for Buttons
    [JDY40.obj, inductance.obj, main.obj, movement_integration.obj]
2024-04-01 Some Changes
    [JDY40.obj, inductance.obj, movement_integration.obj]
2024-04-01 Cleaned RX on STM32 Side
2024-04-02 ISR Issues - Need to Fix Speaker and Period
    [JDY40.obj, main.obj, speaker.obj]
2024-04-02 Period Amendment. Issue with Accuracy. Cannot Calculate Inductance
    [JDY40.obj, inductance.obj, speaker.obj]
2024-04-02 Trying to Fix STM32 Speaker Freqs
    [main.c, movement_integration.c, speaker.c, speaker.h]
2024-04-02 Testing Speaker and Fixed Inductance Precision
    [JDY40.c, JDY40.h, main.c, speaker.c]
2024-04-02 Z is being read and transmitted. Need to fix speaker
    [JDY40.c, JDY40.h, global.h, main.c, movement_integration.c]
2024-04-02 Inductance Calculated - Period Working!!
    [Robot_Base.obj, inductance.obj, movement_integration.obj]
2024-04-02 Speaker Working with Frequencies! Need to fix Sounds! Need to Test Movement!
    [main.c, speaker.c]
2024-04-03 Working but outrageously slow
    [JDY40.obj, inductance.obj]
2024-04-03 NOBODY TOUCH THIS SHIT
    [JDY40.obj, global.obj, inductance.obj, main.obj, movement_integration.obj, speaker.obj]
2024-04-03 Some minor tranmission changes. Metal detector is being slow
    [JDY40.obj, global.obj, inductance.obj, main.obj, movement_integration.obj, speaker.obj]
2024-04-03 Slightly Faster Inductance
    [JDY40.obj, global.obj, inductance.obj, main.obj, movement_integration.obj, speaker.obj]
2024-04-03 Instant Inductance on Both Ends
    [JDY40.obj, global.obj, inductance.obj, main.obj, movement_integration.obj, speaker.obj]
2024-04-03 Inductance is Fixed
    [JDY40.obj]
2024-04-03 SpeakerForce Button Working
2024-04-03 Inductance Thresholds Fixed!
    [main.obj, movement_integration.obj]
2024-04-03 Parking Added. Need to Test with Movement
    [global.obj, main.obj, movement_integration.obj, speaker.obj]
2024-04-03 Parking seems ok
    [JDY40.obj, global.obj, main.obj, movement_integration.obj, speaker.obj]
2024-04-04 Works with Parking.
    [JDY40.obj, main.obj]
2024-04-09 Script for Generating Logs
    [Coordinate_Logs.csv, Inductance_Logs.csv]
2024-04-10 Dedicated Repository for Logs
    [Coordinate_Logs.csv, Inductance_Logs.csv]
2024-04-11 3:00 PM
    [Inductance_Logs.csv, main.obj]
2024-09-11 Documented Final Project
    [Coordinate_Logs.csv, Inductance_Logs.csv, movement.obj, movement_new_new.obj, test_main.obj, testmovement.obj]
