TZlindra/ELEC291Project2/(notices)

Notices in the files:
EFM8/Robot/EFM8_Prog/EFM8_prog.c:
under the terms of the GNU General Public License as published by the
Free Software Foundation; either version 2, or (at your option) any
